Josemarialanda/bike-stuff/track-commuter/drawings/ti_track_commuter_53_sheet2_rear_end.png

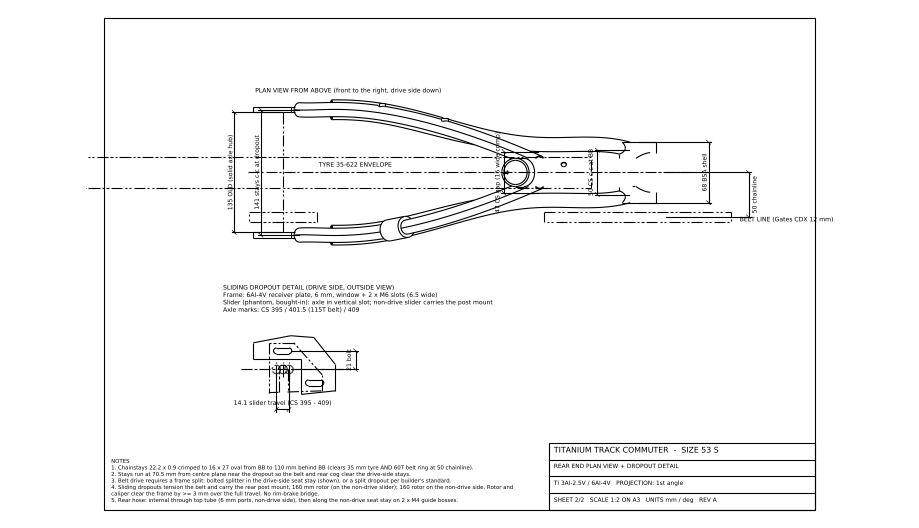
track-commuter/drawings/ti_track_commuter_53_sheet2_rear_end.png
