Josemarialanda/bike-stuff/track-commuter/renders/bike_side_reference.png

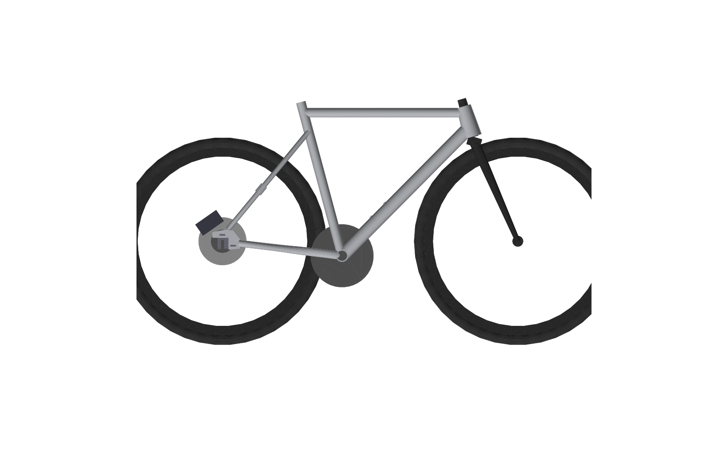
track-commuter/renders/bike_side_reference.png
