Josemarialanda/bike-stuff/track-commuter/renders/frame_rear.png

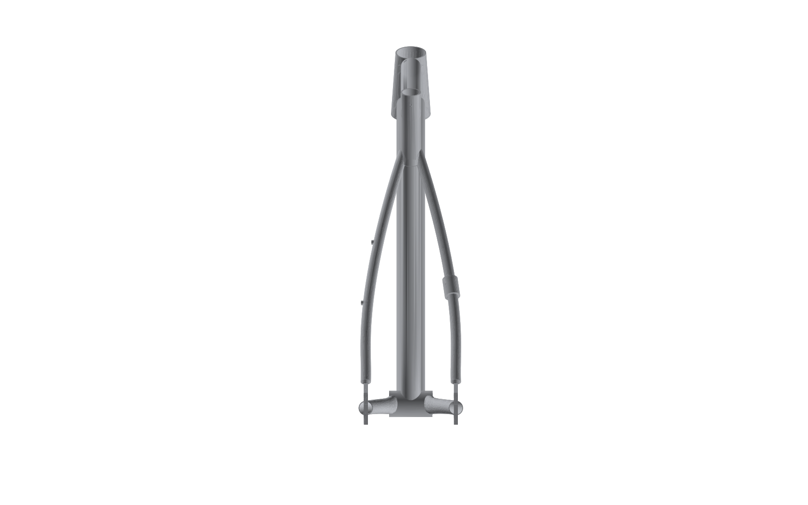
track-commuter/renders/frame_rear.png
