Josemarialanda/bike-stuff/track-commuter/renders/frame_side.png

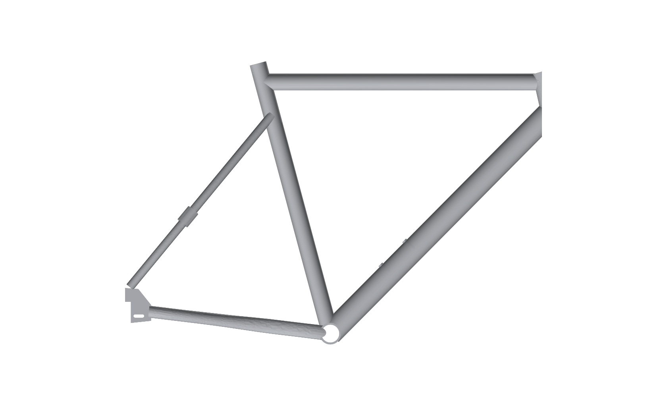
track-commuter/renders/frame_side.png
