Josemarialanda/bike-stuff/track-commuter/cad/ti_track_commuter_53_assembly_reference.step

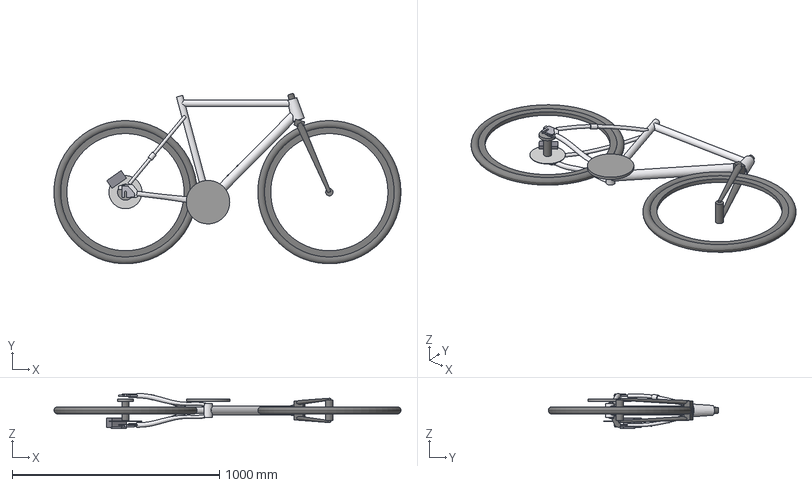
[picture p8: CAD file, 2026-10-21]
track-commuter/cad/ti_track_commuter_53_assembly_reference.step
1676.1 x 823.6 x 169.1 mm
frame_titanium
fork_reference
front_wheel_ref
rear_wheel_ref
belt_sprockets_ref
slider_drive_ref
slider_nondrive_pm_ref
rear_rotor_160_ref
rear_caliper_envelope_ref
