Josemarialanda/bike-stuff/track-commuter/cad/ti_track_commuter_53_frame.step

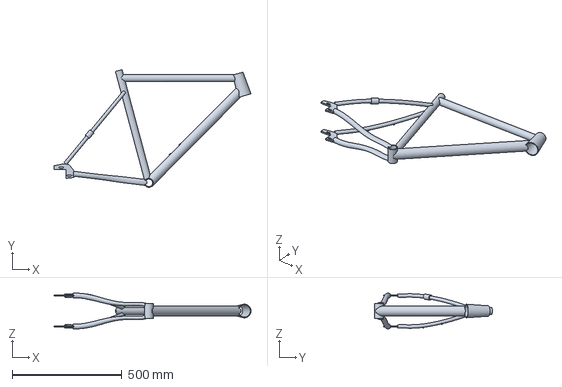
[picture p9: CAD file, 2026-10-21]
track-commuter/cad/ti_track_commuter_53_frame.step
897.7 x 536.6 x 163.2 mm
