Josemarialanda/bike-stuff/track-commuter/drawings/ti_track_commuter_53_sheet2_rear_end.dxf

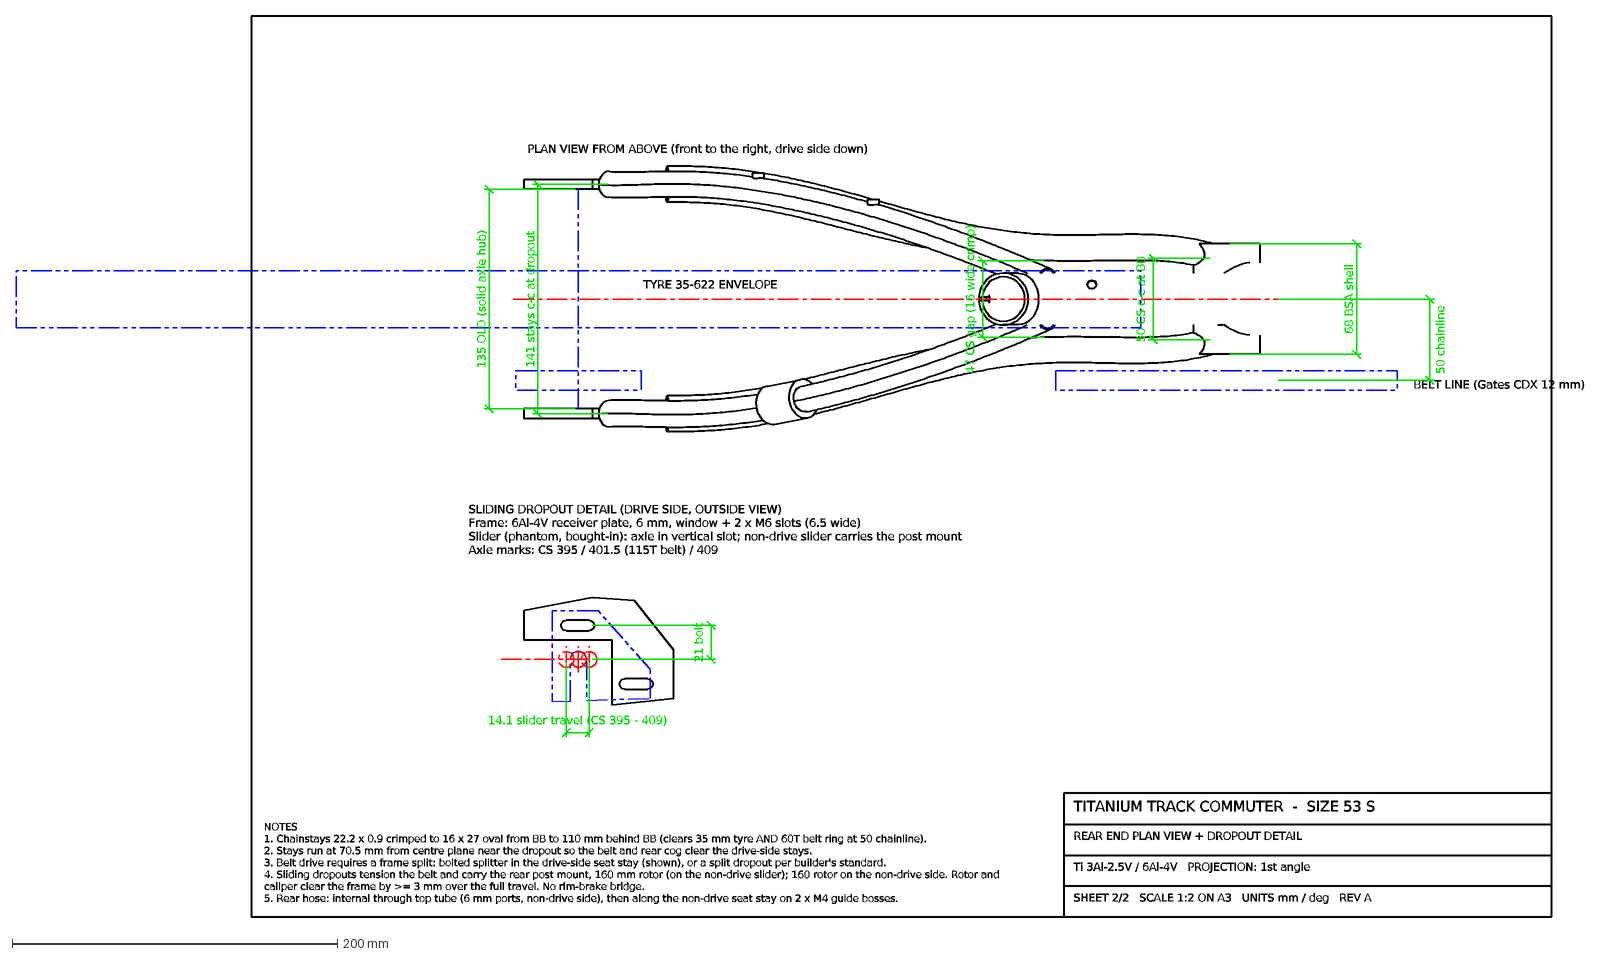
[picture p10: CAD file, 2026-10-21]
track-commuter/drawings/ti_track_commuter_53_sheet2_rear_end.dxf
BELT LINE (Gates CDX 12 mm)
TYRE 35-622 ENVELOPE
135 OLD (solid axle hub)
50 chainline
68 BSA shell
141 stays c-c at dropout
50 CS c-c at BB
47 CS gap (16 wide crimp)
14.1 slider travel (CS 395 - 409)
21 bolt
SLIDING DROPOUT DETAIL (DRIVE SIDE, OUTSIDE VIEW) Frame: 6Al-4V receiver plate, 6 mm, window + 2 x M6 slots (6.5 wide) Slider (phantom, bought-in): axle in vert
PLAN VIEW FROM ABOVE (front to the right, drive side down)
SHEET 2/2 SCALE 1:2 ON A3 UNITS mm / deg REV A
Ti 3Al-2.5V / 6Al-4V PROJECTION: 1st angle
REAR END PLAN VIEW + DROPOUT DETAIL
TITANIUM TRACK COMMUTER - SIZE 53 S
NOTES 1. Chainstays 22.2 x 0.9 crimped to 16 x 27 oval from BB to 110 mm behind BB (clears 35 mm tyre AND 60T belt ring at 50 chainline). 2. Stays run at 70.5 m
