Josemarialanda/bike-stuff/track-commuter/drawings/ti_track_commuter_53_sheet1_side_elevation.dxf

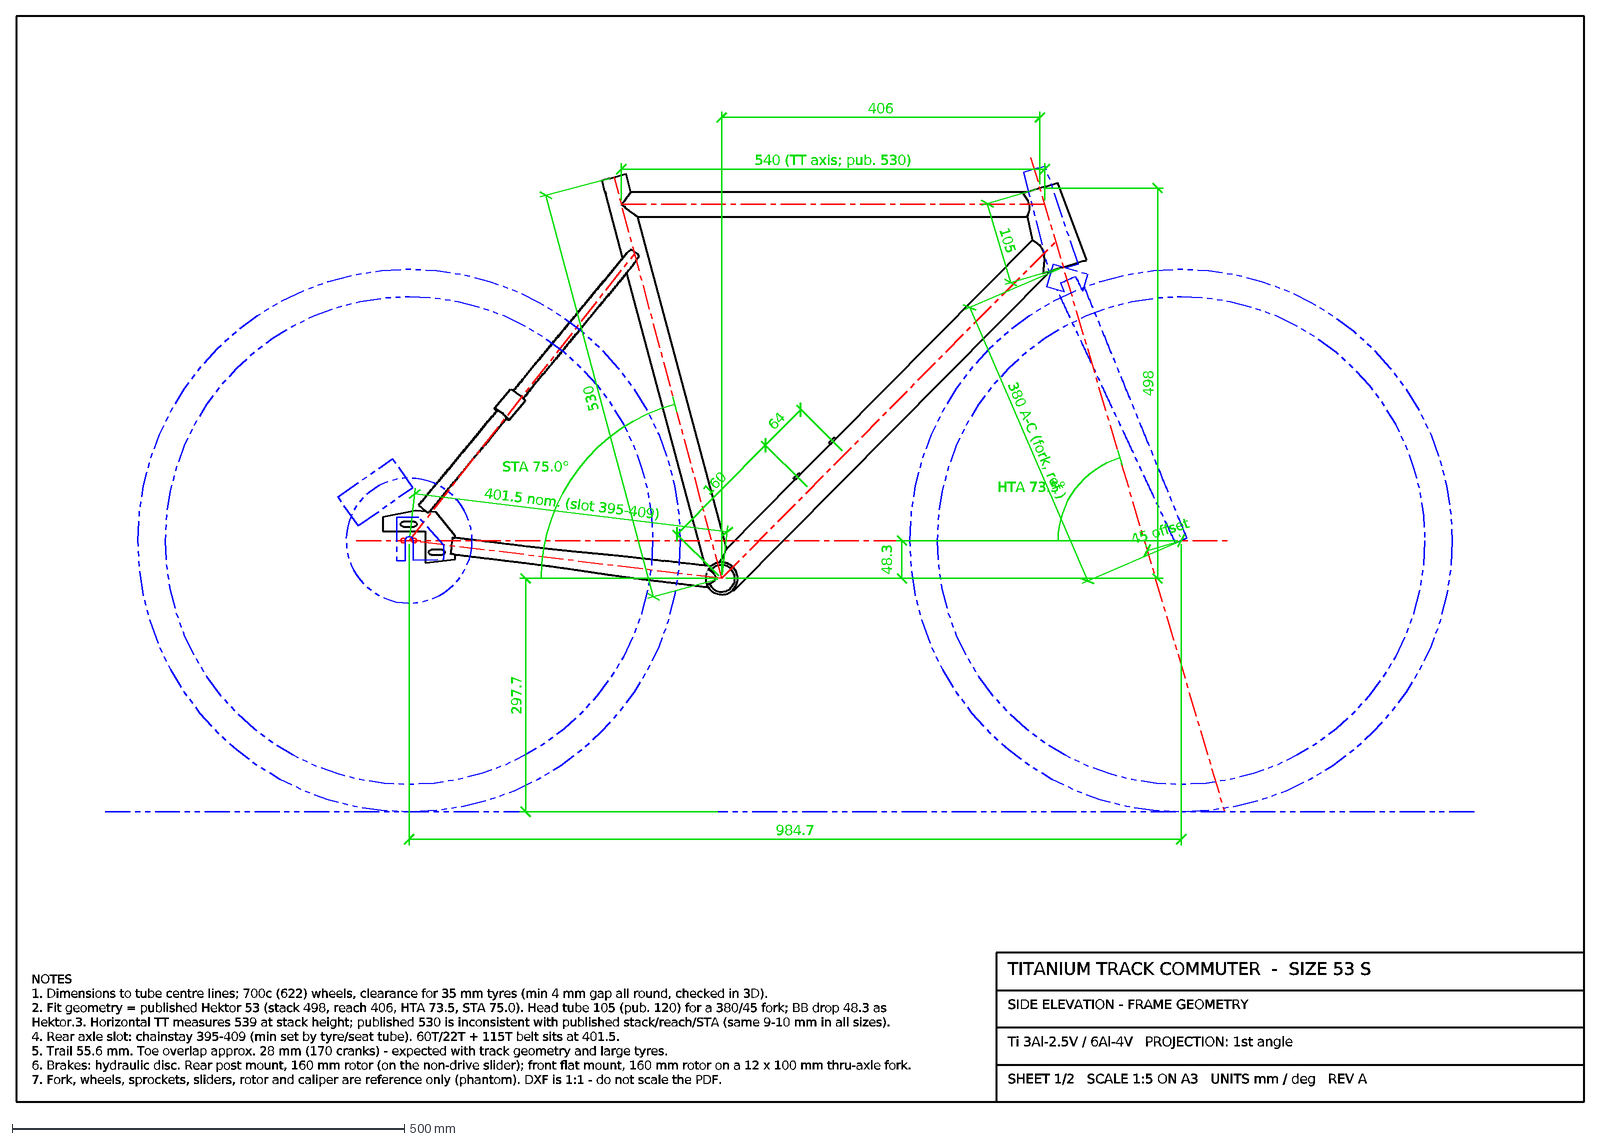
[picture p11: CAD file, 2026-10-21]
track-commuter/drawings/ti_track_commuter_53_sheet1_side_elevation.dxf
498
406
105
HTA 73.5°
STA 75.0°
530
540 (TT axis; pub. 530)
401.5 nom. (slot 395-409)
984.7
48.3
297.7
380 A-C (fork, ref.)
45 offset
160
64
SHEET 1/2 SCALE 1:5 ON A3 UNITS mm / deg REV A
Ti 3Al-2.5V / 6Al-4V PROJECTION: 1st angle
SIDE ELEVATION - FRAME GEOMETRY
TITANIUM TRACK COMMUTER - SIZE 53 S
NOTES 1. Dimensions to tube centre lines; 700c (622) wheels, clearance for 35 mm tyres (min 4 mm gap all round, checked in 3D). 2. Fit geometry = published Hekt
