Josemarialanda/bike-stuff/(list of files, cad)

Other CAD files:
track-commuter/cad/ti_track_commuter_53_frame.stl
