Josemarialanda/bike-stuff/track-commuter/drawings/ti_track_commuter_53_sheet1_side_elevation.pdf

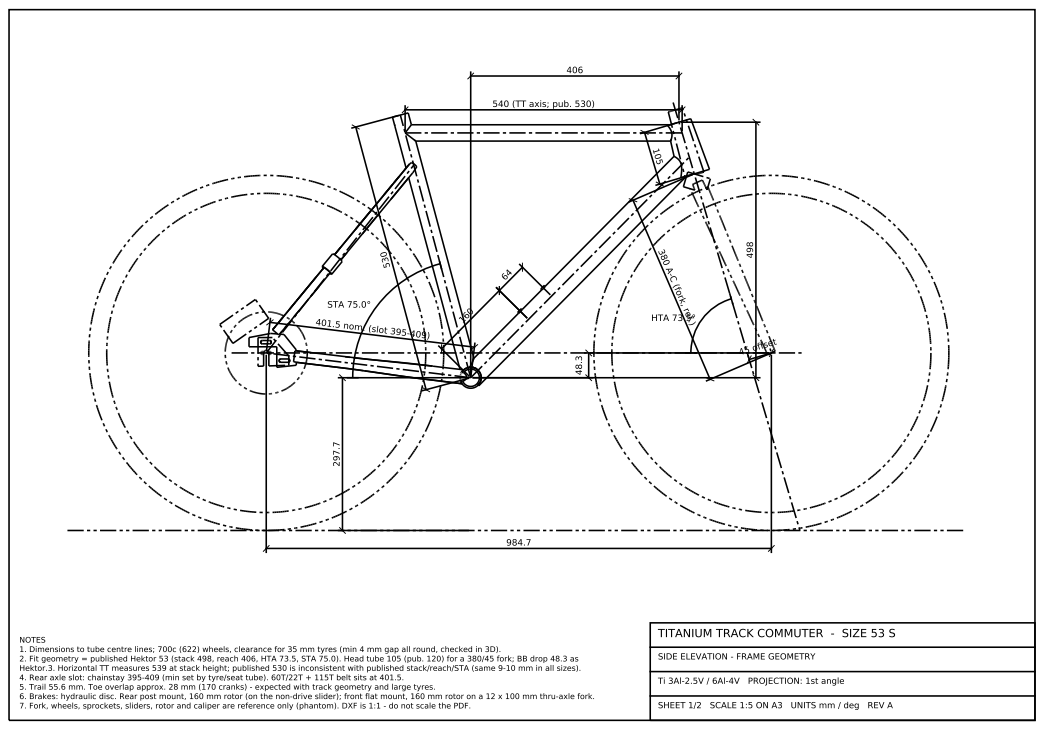
[picture p12: page 1]
