Josemarialanda/bike-stuff/track-commuter/drawings/ti_track_commuter_53_sheet2_rear_end.pdf

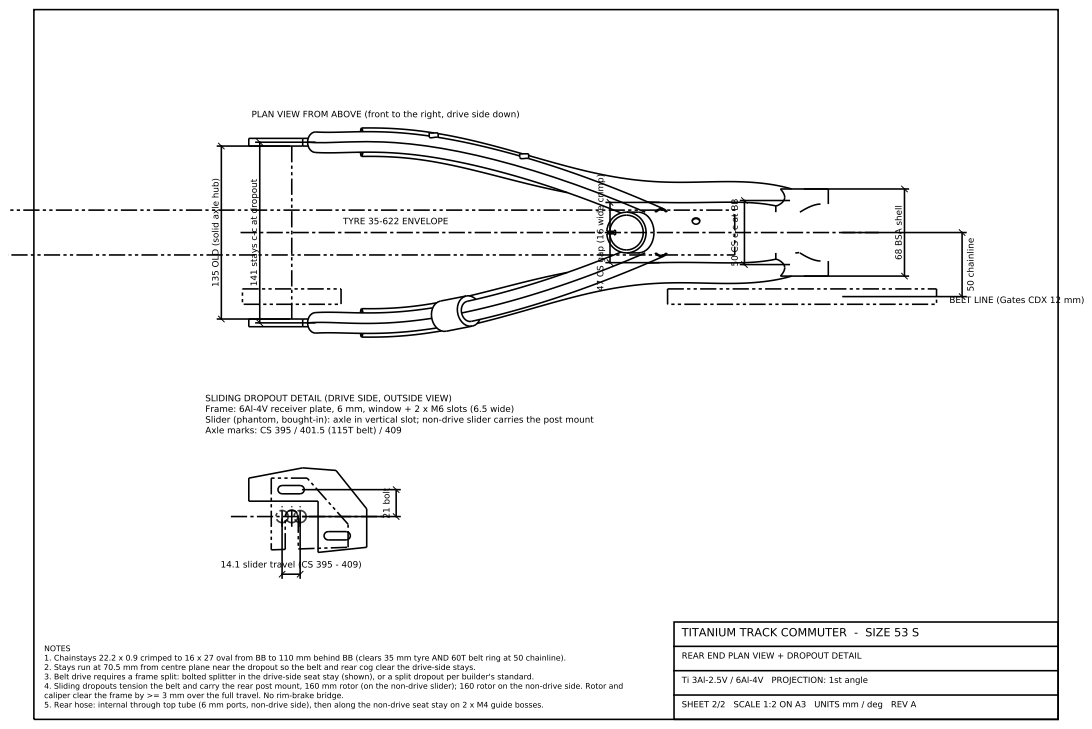
[picture p13: page 1]
