Josemarialanda/bike-stuff/(commit log)

2026-10-21 Add titanium track commuter (Hektor geometry, size 53) design files
    Parametric CadQuery model with STEP/STL, 1:1 DXF + A3 PDF/SVG drawings,
    and a builder spec sheet. Geometry taken from Schindelhauer's published
    Hektor table; BB drop and fork derived to match the published wheelbase.
    Claude-Session: https://claude.ai/code/session_01DuVMLnKvto8nk4chxdy2NQ
    [ti_track_commuter_53_assembly_reference.step, ti_track_commuter_53_frame.step, ti_track_commuter_53_frame.stl, ti_track_commuter_53_geometry.csv, ti_track_commuter_53_sheet1_side_elevation.dxf, ti_track_commuter_53_sheet2_rear_end.dxf]
2026-10-21 Redesign track commuter for 35 mm tyre clearance
    - Chainstay slot 395-409 (seat-tube clearance), 115T belt
    - 135 mm hub / 50 mm chainline so chainstays fit between tyre and belt ring
    - 380 A-C fork with head tube shortened to 105 (stack/reach/BB drop unchanged)
    - Seat stays converge later; brake bridge placed 4 mm above tyre
    - New checks.py: 3D tyre and belt clearance checks, enforced in build
    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
    [ti_track_commuter_53_assembly_reference.step, ti_track_commuter_53_frame.step, ti_track_commuter_53_frame.stl, ti_track_commuter_53_geometry.csv, ti_track_commuter_53_sheet1_side_elevation.dxf, ti_track_commuter_53_sheet2_rear_end.dxf]
2026-10-21 Switch to disc brakes with sliding dropouts
    - Receiver plates for bolt-on sliders replace horizontal track ends
    - Rear post mount (160 rotor) on the non-drive slider; front flat-mount
    12x100 disc fork; rim-brake bridge removed
    - Rear hose: internal top tube + 2 guide bosses on non-drive seat stay
    - Rotor/caliper clearance and solid tyre distance added to checks.py
    - Drawings, spec sheet and README updated
    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
    [ti_track_commuter_53_assembly_reference.step, ti_track_commuter_53_frame.step, ti_track_commuter_53_frame.stl, ti_track_commuter_53_sheet1_side_elevation.dxf, ti_track_commuter_53_sheet2_rear_end.dxf]
